adafruit/Adafruit-PCM510x-I2S-DAC-PCB/Adafruit PCM510x I2S DAC.brd

## EAGLE design Adafruit PCM510x I2S DAC.brd (2025-03-03)

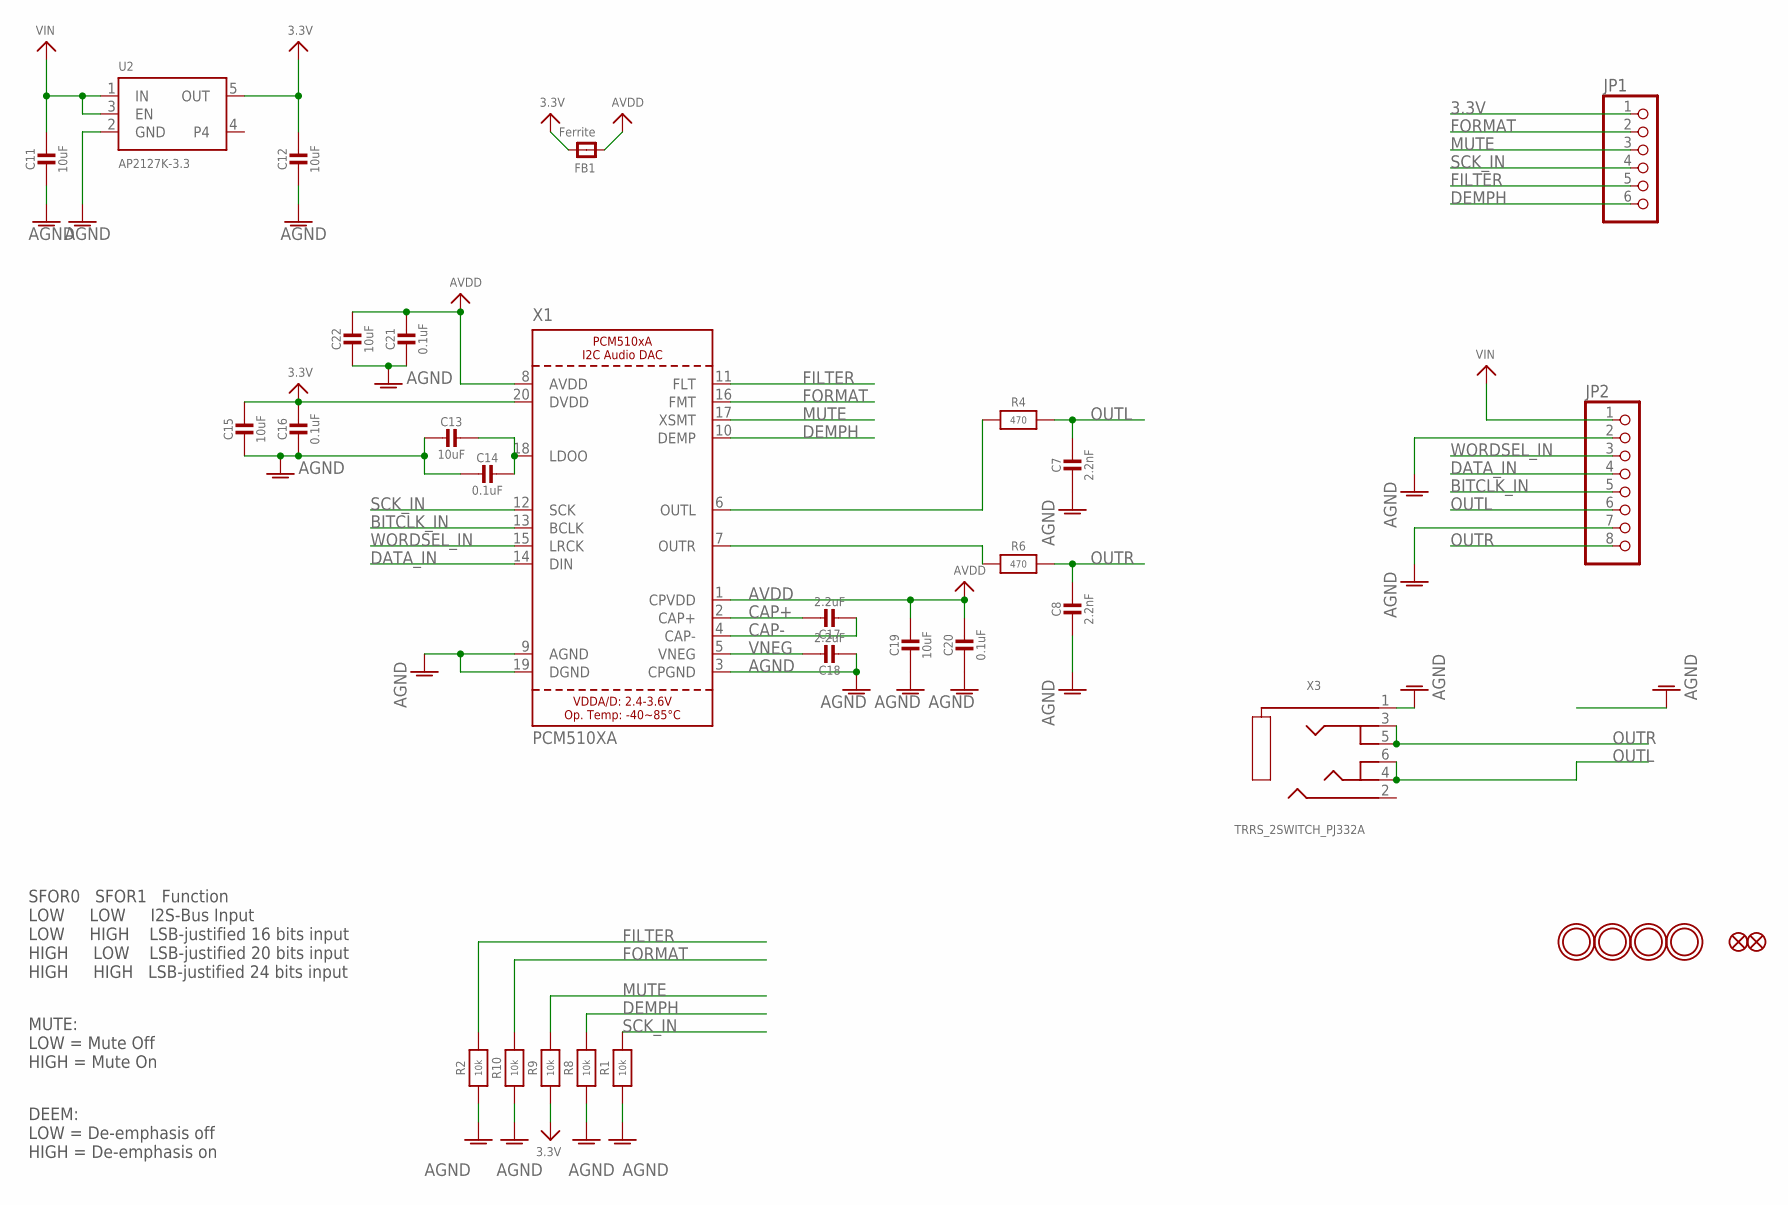
[picture p3: schematic Adafruit PCM510x I2S DAC.sch]

Parts:
C7, C8: 2.2nF; 0603-NO
C11, C12, C13, C15, C19, C22: 10uF; 0805-NO
C14, C16, C20, C21: 0.1uF; 0603-NO
C17, C18: 2.2uF; 0603-NO
FB1: Ferrite; 0603-NO
FID1, FID2: FIDUCIAL_0.5MM
JP1: HEADER-1X670MIL; 1X06_ROUND_70
JP2: HEADER-1X8ROUND; 1X08_ROUND
R1, R2, R8, R9, R10: 10k; 0603-NO
R4, R6: 470; 0603-NO
U2: AP2127K-3.3; SOT23-5
U$11, U$12, U$13, U$14: MOUNTINGHOLE2.5; MOUNTINGHOLE_2.5_PLATED
X1: PCM510XA; TSSOP20
X3: TRRS_2SWITCH_PJ332A; PJ-332A

Connections:
3.3V: C12.1, C15.1, C16.1, FB1.2, JP1.1, R9.1, U2.5 (OUT), X1.20 (DVDD)
AGND: C7.2, C8.2, C11.2, C12.2, C13.2, C14.2, C15.2, C16.2, C18.2, C19.2, C20.2, C21.2, C22.2, JP2.2, JP2.7, R1.1, R2.1, R8.1, R10.1, U2.2 (GND), X1.3 (CPGND), X1.9 (AGND), X1.19 (DGND), X3.1 (RING)
AVDD: C19.1, C20.1, C21.1, C22.1, FB1.1, X1.1 (CPVDD), X1.8 (AVDD)
BITCLK_IN: JP2.5, X1.13 (BCLK)
CAP+: C17.1, X1.2 (CAP+)
CAP-: C17.2, X1.4 (CAP-)
DATA_IN: JP2.4, X1.14 (DIN)
DEMPH: JP1.6, R8.2, X1.10 (DEMP)
FILTER: JP1.5, R2.2, X1.11 (FLT)
FORMAT: JP1.2, R10.2, X1.16 (FMT)
MUTE: JP1.3, R9.2, X1.17 (XSMT)
unnamed: R6.1, X1.7 (OUTR)
unnamed: R4.1, X1.6 (OUTL)
unnamed: C13.1, C14.1, X1.18 (LDOO)
OUTL: C7.1, JP2.6, R4.2, X3.4 (TIP), X3.6 (TIP_SW)
OUTR: C8.1, JP2.8, R6.2, X3.3 (RING2), X3.5 (R2_SW)
SCK_IN: JP1.4, R1.2, X1.12 (SCK)
VIN: C11.1, JP2.1, U2.1 (IN), U2.3 (EN)
VNEG: C18.1, X1.5 (VNEG)
WORDSEL_IN: JP2.3, X1.15 (LRCK)

Notes on the sheet:
MUTE: LOW = Mute Off HIGH = Mute On
DEEM: LOW = De-emphasis off HIGH = De-emphasis on
SFOR0 SFOR1 Function LOW LOW I2S-Bus Input LOW HIGH LSB-justified 16 bits input HIGH LOW LSB-justified 20 bits input HIGH HIGH LSB-justified 24 bits input

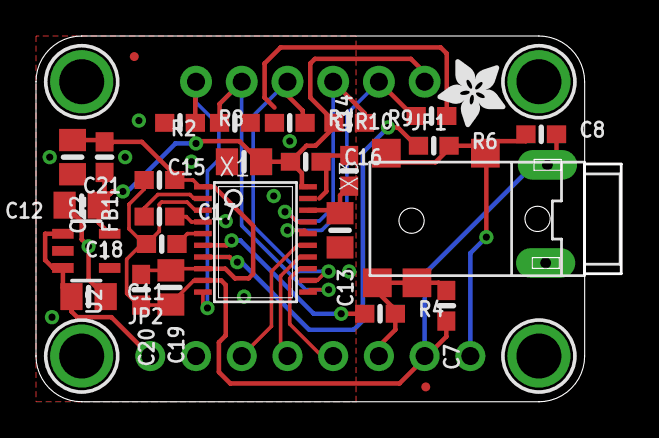
[picture p4: board Adafruit PCM510x I2S DAC.brd from above]

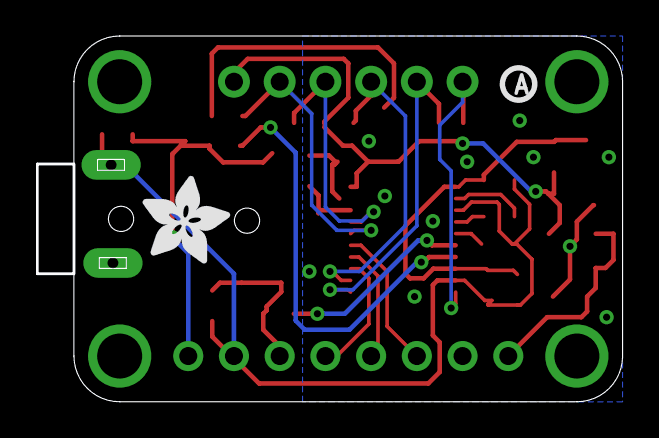
[picture p5: board Adafruit PCM510x I2S DAC.brd from below]

Board: 2 copper layers, 32.5 x 20.3 mm, 54 parts (5 on the bottom side), 20 nets.

Other parts of the board:
PLABEL0: PLABEL0
PLABEL1: PLABEL1
PLABEL2: PLABEL2
PLABEL3: PLABEL3
PLABEL4: PLABEL4
PLABEL5: PLABEL5
PLABEL6: PLABEL6
PLABEL7: PLABEL7
PLABEL8: PLABEL8
PLABEL9: PLABEL9
PLABEL10: PLABEL10
PLABEL11: PLABEL11
PLABEL12: PLABEL12
PLABEL13: PLABEL13
PLABEL16: PLABEL16
PLABEL17: PLABEL17
PLABEL18: PLABEL18
PLABEL19: PLABEL19
U$5: PCBFEAT-REV-040
U$6: ADAFRUIT_5MM
U$29: ADAFRUIT_3.5MM
